juanbruzzone/arcade/cad/Drive_Sprocket_Orthographic (1).pdf

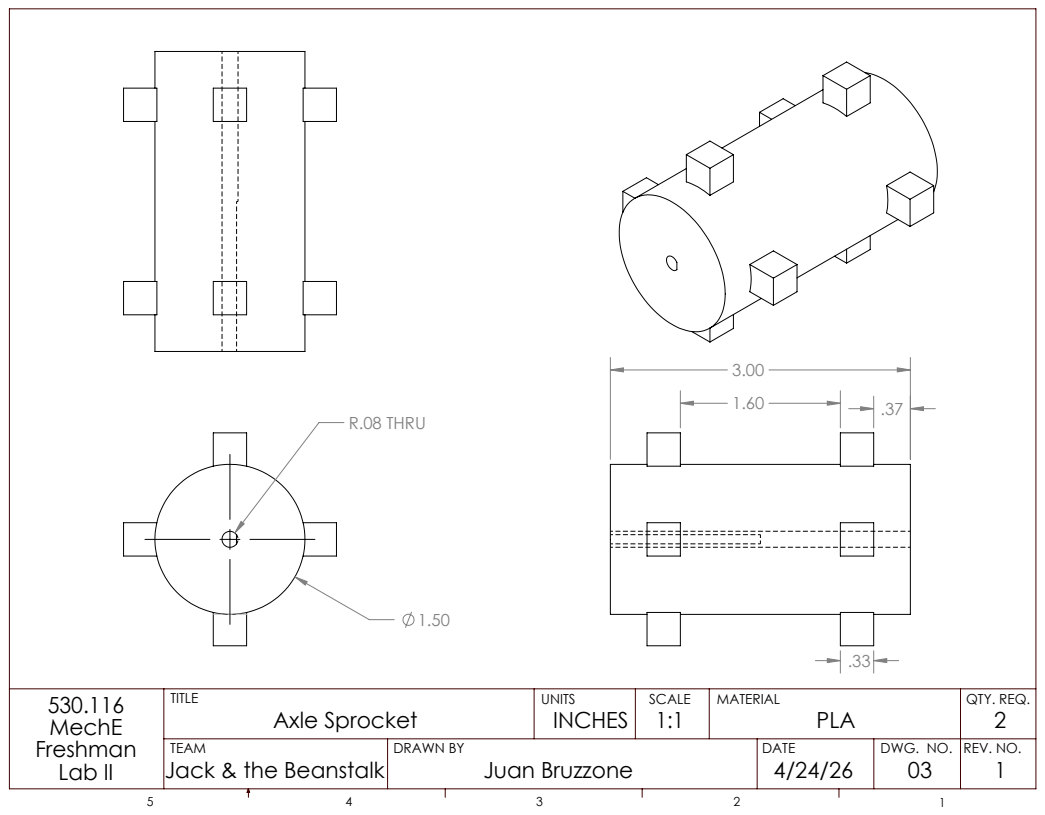
[picture p11: page 1]
R.08 THRU; DRAWN BY; DATE; DWG. NO.; REV. NO.; TITLE; SCALE; MATERIAL; QTY. REQ.; Axle Sprocket; Juan Bruzzone; Lab II

TEAM
Jack & the Beanstalk
