juanbruzzone/arcade/cad/Game_Belt_Exploded.pdf

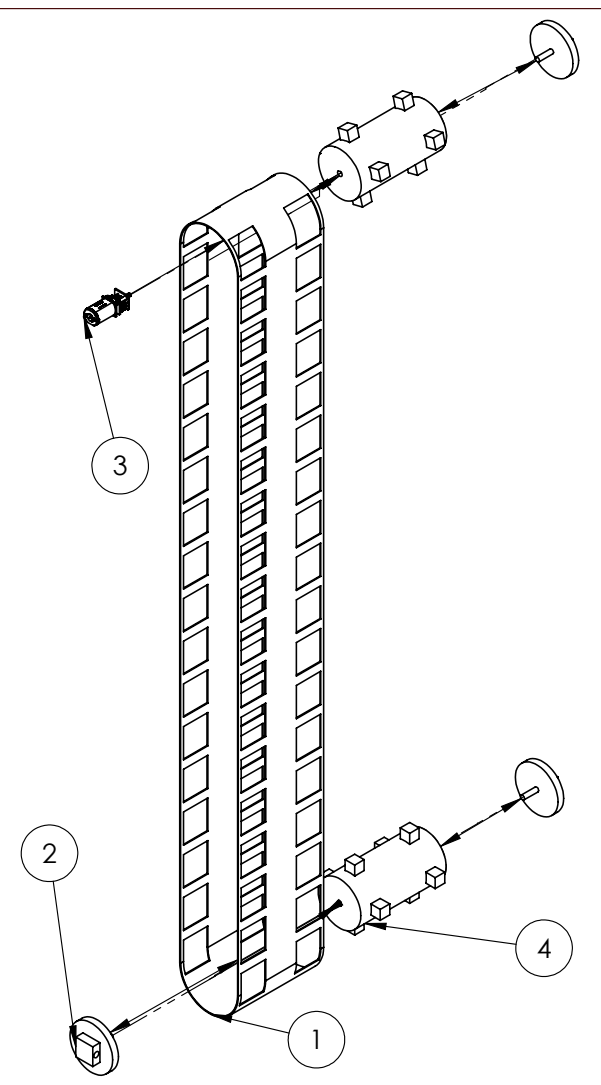
[picture p12: page 1]
DRAWN BY; DATE; DWG. NO.; REV. NO.; TITLE; SCALE; MATERIAL; QTY. REQ.; Vertical Band - Exploded; Juan Bruzzone; Lab II

ITEM NO. | PART NUMBER | QTY.
1 | Band Belt | 1
2 | Band Peg | 3
3 | N20 Gear Motor.step | 1
4 | 3D Print Sprocket | 2

TEAM
Jack & the Beanstalk
