juanbruzzone/arcade/cad/Game_Belt_Orthographic.pdf

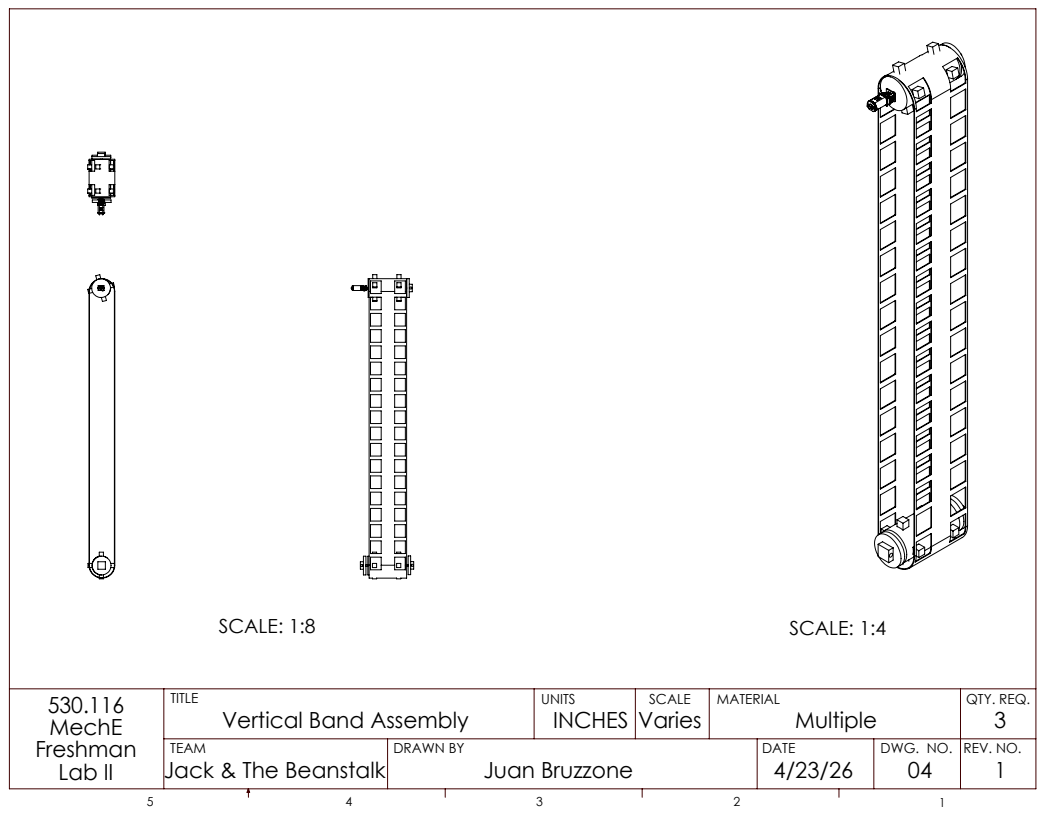
[picture p13: page 1]
SCALE: 1:8; SCALE: 1:4; DRAWN BY; DATE; DWG. NO.; REV. NO.; TITLE; SCALE; MATERIAL; QTY. REQ.; Vertical Band Assembly; Varies; Juan Bruzzone; Lab II

TEAM
Jack & The Beanstalk
