juanbruzzone/arcade/cad/Idler_Roller_Orthographic.pdf

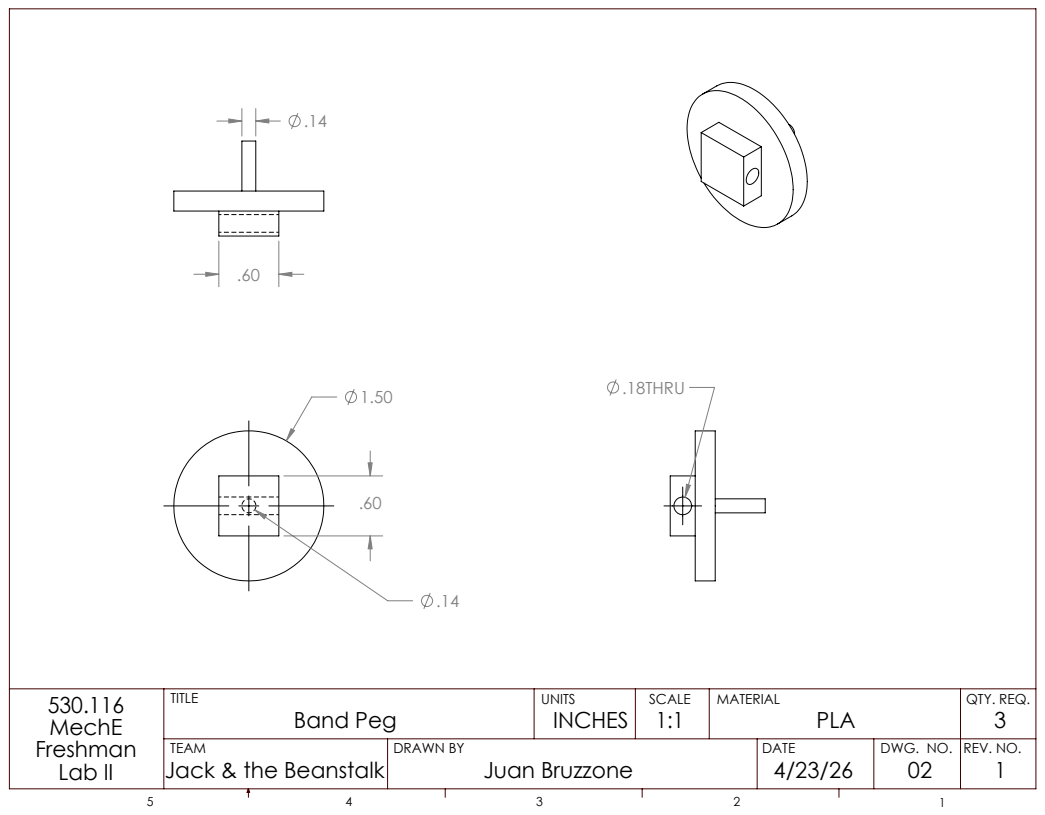
[picture p14: page 1]
DRAWN BY; DATE; DWG. NO.; REV. NO.; TITLE; SCALE; MATERIAL; QTY. REQ.; Band Peg; Juan Bruzzone; Lab II

TEAM
Jack & the Beanstalk
