juanbruzzone/arcade/cad/Slotted_Drive_Belt_Orthographic.pdf

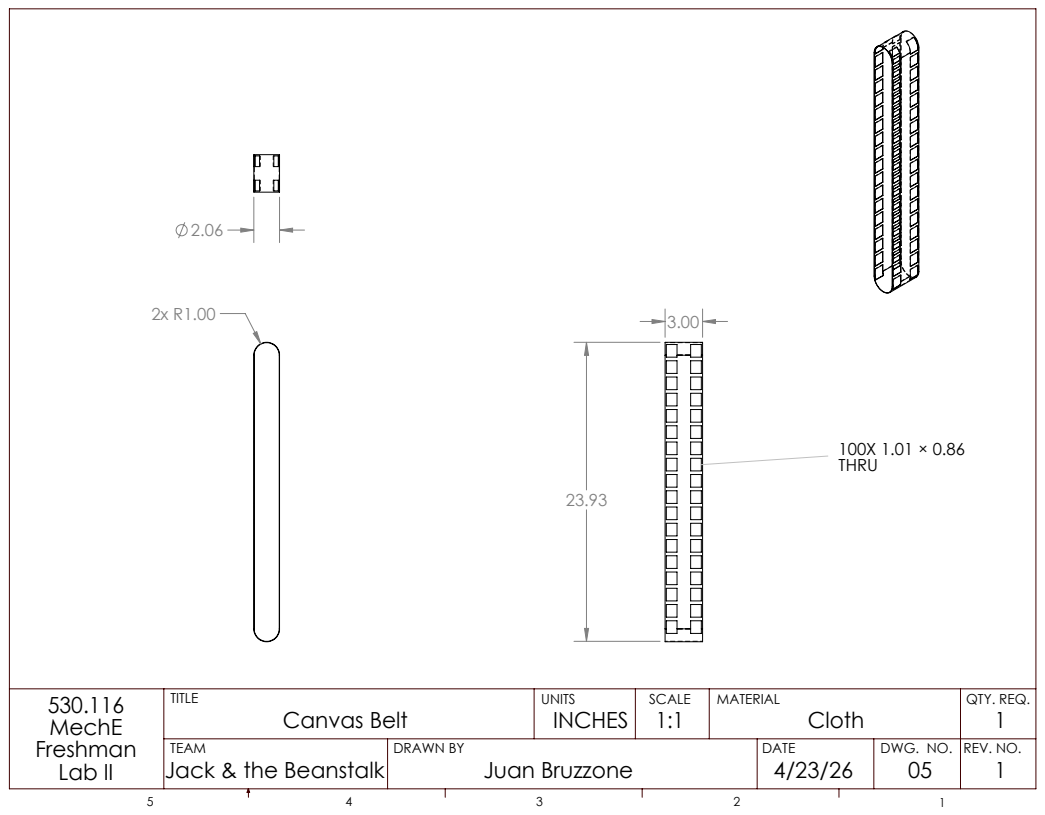
[picture p15: page 1]
DRAWN BY; DATE; DWG. NO.; REV. NO.; TITLE; SCALE; MATERIAL; QTY. REQ.; Canvas Belt; Juan Bruzzone; Lab II

TEAM
Jack & the Beanstalk
