juanbruzzone/arcade/images/FinalBuild1.JPG

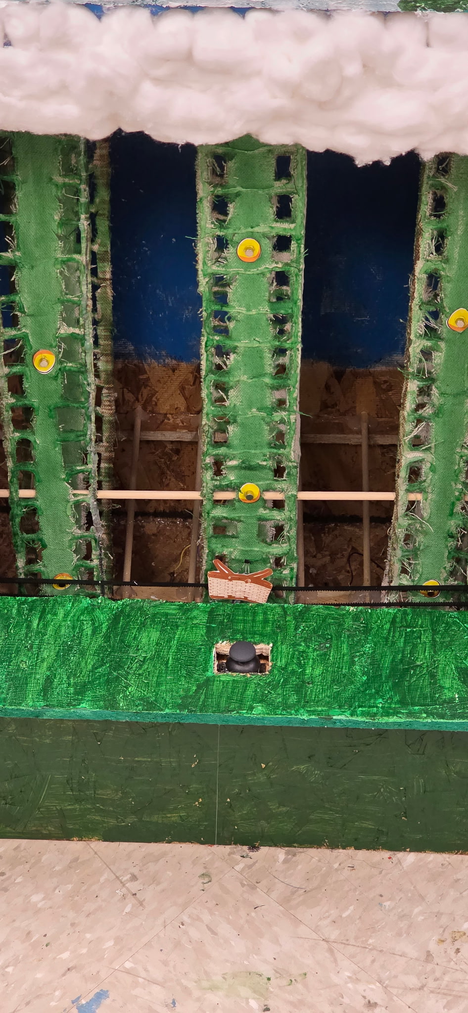
images/FinalBuild1.JPG
