juanbruzzone/arcade/images/FinalBuild3.JPG

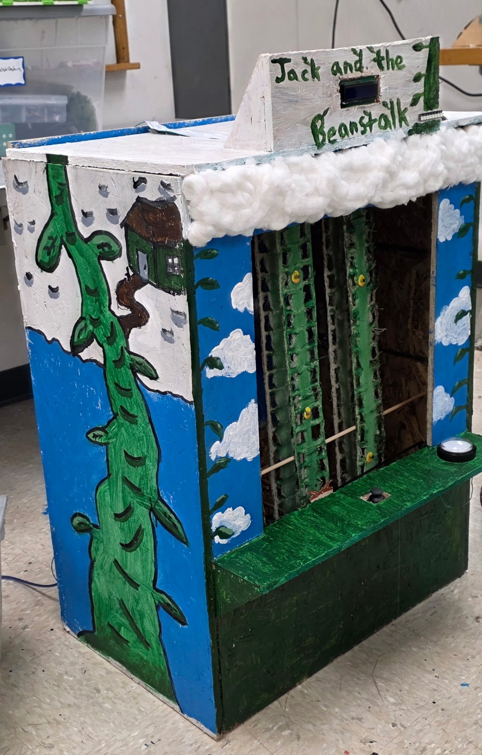
images/FinalBuild3.JPG
